dragonplus-electronics/Atom-Iss5-V002/CpuRoms8255PIA.kicad_sch

## KiCad design CpuRoms8255PIA.kicad_sch (2025-06-12)

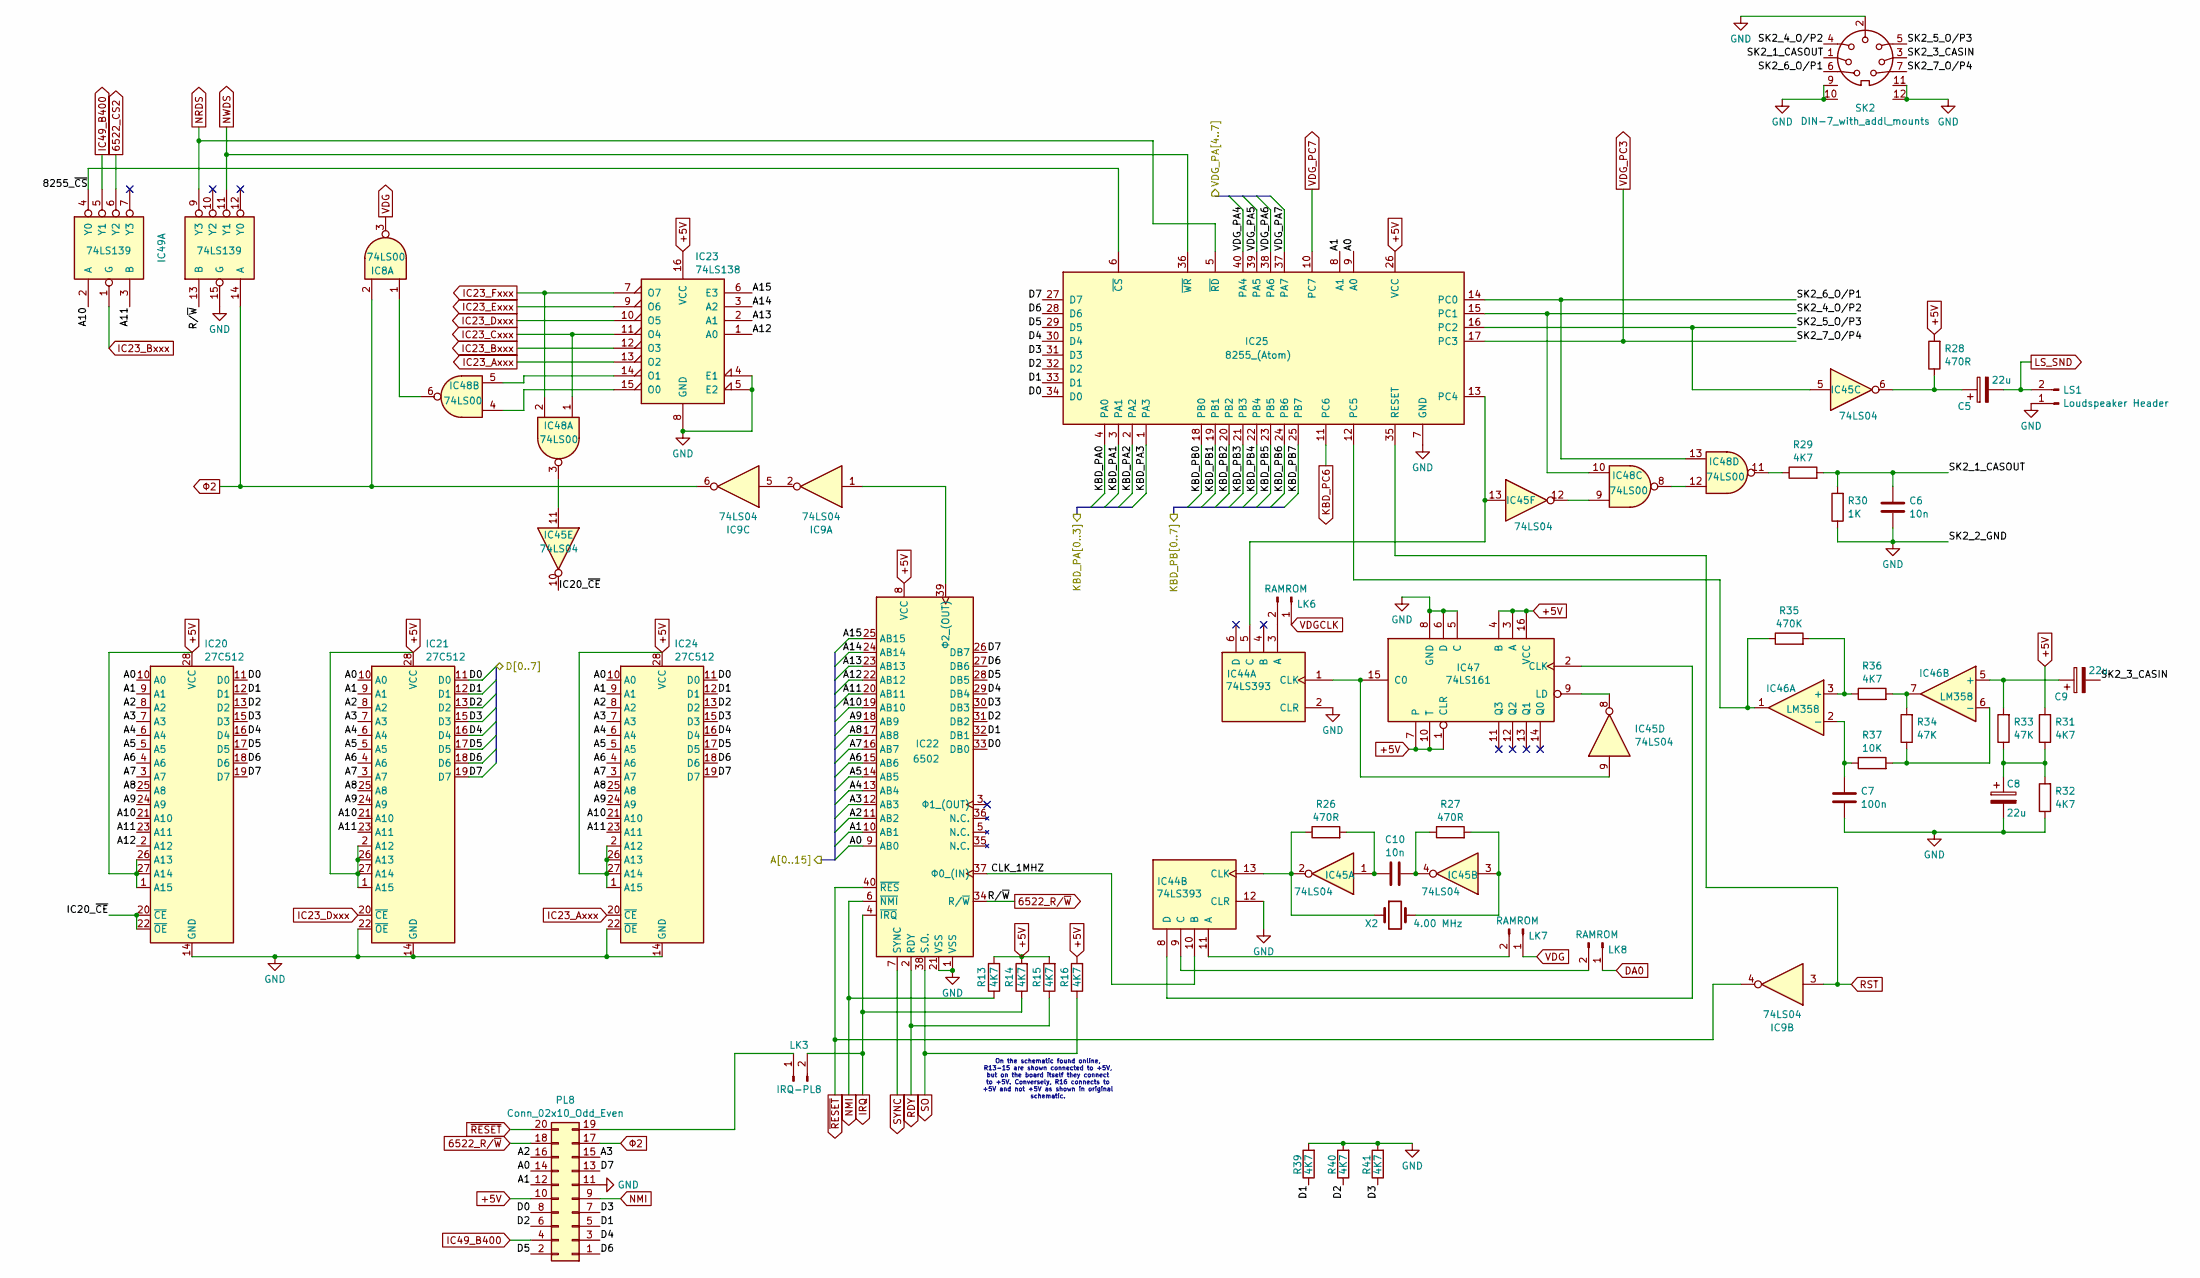
[picture p1: schematic CpuRoms8255PIA.kicad_sch]

Parts:
C5, C8, C9: 22u; CP_Radial_D5.0mm_P2.00mm
C6, C10: 10n; C_Disc_D3.0mm_W1.6mm_P2.50mm
C7: 100n; C_Disc_D3.0mm_W1.6mm_P2.50mm
IC8, IC48: 74LS00; DIP-14_W7.62mm
IC9, IC45: 74LS04; DIP-14_W7.62mm
IC20, IC21, IC24: 27C512; DIP-28_W15.24mm
IC22: 6502; DIP-40_W15.24mm
IC23: 74LS138; DIP-16_W7.62mm
IC25: 8255_(Atom); DIP-40_W15.24mm
IC44: 74LS393; DIP-14_W7.62mm
IC46: LM358; DIP-8_W7.62mm
IC47: 74LS161; DIP-16_W7.62mm
IC49: 74LS139; DIP-16_W7.62mm
LK3: IRQ-PL8; PinHeader_1x02_P2.54mm_Vertical
LK6, LK7, LK8: RAMROM; PinHeader_1x02_P2.54mm_Vertical
LS1: Loudspeaker Header; PinHeader_1x02_P2.54mm_Vertical
PL8: Conn_02x10_Odd_Even; Atom_IDC-Header_2x10_P2.54mm_Vertical
R13, R14, R15, R16, R29, R31, R32, R36, R39, R40, R41: 4K7; R_Axial_DIN0204_L3.6mm_D1.6mm_P5.08mm_Horizontal
R26, R27, R28: 470R; R_Axial_DIN0204_L3.6mm_D1.6mm_P5.08mm_Horizontal
R30: 1K; R_Axial_DIN0204_L3.6mm_D1.6mm_P5.08mm_Horizontal
R33, R34: 47K; R_Axial_DIN0204_L3.6mm_D1.6mm_P5.08mm_Horizontal
R35: 470K; R_Axial_DIN0204_L3.6mm_D1.6mm_P5.08mm_Horizontal
R37: 10K; R_Axial_DIN0204_L3.6mm_D1.6mm_P5.08mm_Horizontal
SK2: DIN-7_with_addl_mounts; DIN-7_RA
X2: 4.00 MHz; Crystal_HC49-4H_Vertical

Connections:
6522_CS2: IC49.6 (Y2)
6522_R/~W: IC22.34 (R/~W), IC49.13 (B), PL8.18
8255_~CS: IC25.6 (~CS), IC49.4 (Y0)
+5V: IC20.1 (A15), IC20.26 (A13), IC20.27 (A14), IC20.28 (VCC), IC21.1 (A15), IC21.2 (A12), IC21.26 (A13), IC21.27 (A14), IC21.28 (VCC), IC22.8 (VCC), IC23.16 (VCC), IC24.1 (A15), IC24.2 (A12), IC24.26 (A13), IC24.27 (A14), IC24.28 (VCC), IC25.26 (VCC), IC47.1 (CLR), IC47.3 (A), IC47.4 (B), IC47.7, IC47.10 (T), IC47.16 (VCC), PL8.10, R13.2, R14.2, R15.2, R16.2, R28.2, R31.2
A0: IC20.10 (A0), IC21.10 (A0), IC22.9 (AB0), IC24.10 (A0), IC25.9 (A0), PL8.14
A1: IC20.9 (A1), IC21.9 (A1), IC22.10 (AB1), IC24.9 (A1), IC25.8 (A1), PL8.12
A2: IC20.8 (A2), IC21.8 (A2), IC22.11 (AB2), IC24.8 (A2), PL8.16
A3: IC20.7 (A3), IC21.7 (A3), IC22.12 (AB3), IC24.7 (A3), PL8.15
A4: IC20.6 (A4), IC21.6 (A4), IC22.13 (AB4), IC24.6 (A4)
A5: IC20.5 (A5), IC21.5 (A5), IC22.14 (AB5), IC24.5 (A5)
A6: IC20.4 (A6), IC21.4 (A6), IC22.15 (AB6), IC24.4 (A6)
A7: IC20.3 (A7), IC21.3 (A7), IC22.16 (AB7), IC24.3 (A7)
A8: IC20.25 (A8), IC21.25 (A8), IC22.17 (AB8), IC24.25 (A8)
A9: IC20.24 (A9), IC21.24 (A9), IC22.18 (AB9), IC24.24 (A9)
A10: IC20.21 (A10), IC21.21 (A10), IC22.19 (AB10), IC24.21 (A10), IC49.2 (A)
A11: IC20.23 (A11), IC21.23 (A11), IC22.20 (AB11), IC24.23 (A11), IC49.3 (B)
A12: IC20.2 (A12), IC22.22 (AB12), IC23.1 (A0)
A13: IC22.23 (AB13), IC23.2 (A1)
A14: IC22.24 (AB14), IC23.3 (A2)
A15: IC22.25 (AB15), IC23.6 (E3)
CLK_1MHZ: IC22.37 (Φ0_(IN)), IC44.10 (B)
D0: IC20.11 (D0), IC21.11 (D0), IC22.33 (DB0), IC24.11 (D0), IC25.34 (D0), PL8.8
D1: IC20.12 (D1), IC21.12 (D1), IC22.32 (DB1), IC24.12 (D1), IC25.33 (D1), PL8.5, R39.1
D2: IC20.13 (D2), IC21.13 (D2), IC22.31 (DB2), IC24.13 (D2), IC25.32 (D2), PL8.6, R40.1
D3: IC20.15 (D3), IC21.15 (D3), IC22.30 (DB3), IC24.15 (D3), IC25.31 (D3), PL8.7, R41.1
D4: IC20.16 (D4), IC21.16 (D4), IC22.29 (DB4), IC24.16 (D4), IC25.30 (D4), PL8.3
D5: IC20.17 (D5), IC21.17 (D5), IC22.28 (DB5), IC24.17 (D5), IC25.29 (D5), PL8.2
D6: IC20.18 (D6), IC21.18 (D6), IC22.27 (DB6), IC24.18 (D6), IC25.28 (D6), PL8.1
D7: IC20.19 (D7), IC21.19 (D7), IC22.26 (DB7), IC24.19 (D7), IC25.27 (D7), PL8.13
DA0: LK8.1
GND: C6.2, C7.1, C8.2, IC20.14 (GND), IC21.14 (GND), IC21.22 (~OE), IC22.1 (VSS), IC22.21 (VSS), IC23.4 (E1), IC23.5 (E2), IC23.8 (GND), IC24.14 (GND), IC24.22 (~OE), IC25.7 (GND), IC44.2 (CLR), IC44.12 (CLR), IC47.5 (C), IC47.6 (D), IC47.8 (GND), IC49.15 (G), LS1.1, PL8.11, R30.1, R32.1, R39.2, R40.2, R41.2, SK2.2, SK2.9, SK2.10, SK2.11, SK2.12
IC20_~CE: IC20.20 (~CE), IC20.22 (~OE), IC45.10
IC23_Axxx: IC23.13 (O2), IC24.20 (~CE)
IC23_Bxxx: IC23.12 (O3), IC49.1 (G)
IC23_Cxxx: IC23.11 (O4), IC48.1
IC23_Dxxx: IC21.20 (~CE), IC23.10 (O5)
IC23_Exxx: IC23.9 (O6)
IC23_Fxxx: IC23.7 (O7), IC48.2
IC49_B400: IC49.5 (Y1), PL8.4
IRQ: IC22.4 (~IRQ), LK3.2, R14.1
KBD_PA0: IC25.4 (PA0)
KBD_PA1: IC25.3 (PA1)
KBD_PA2: IC25.2 (PA2)
KBD_PA3: IC25.1 (PA3)
KBD_PB0: IC25.18 (PB0)
KBD_PB1: IC25.19 (PB1)
KBD_PB2: IC25.20 (PB2)
KBD_PB3: IC25.21 (PB3)
KBD_PB4: IC25.22 (PB4)
KBD_PB5: IC25.23 (PB5)
KBD_PB6: IC25.24 (PB6)
KBD_PB7: IC25.25 (PB7)
KBD_PC6: IC25.11 (PC6)
LS_SND: C5.2, LS1.2
NMI: IC22.6 (~NMI), PL8.9, R13.1
NRDS: IC25.5 (~RD), IC49.9 (Y3)
NWDS: IC25.36 (~WR), IC49.11 (Y1)
unnamed: C5.1, IC45.6, R28.1
unnamed: C7.2, IC46.2 (-), R37.1
unnamed: C8.1, R31.1, R32.2, R33.1
unnamed: C9.1, IC46.5 (+), R33.2
unnamed: C10.1, IC45.1, R26.2
unnamed: C10.2, IC45.4, R27.1
unnamed: IC9.2, IC9.5
unnamed: IC9.1, IC22.39 (Φ2_(OUT))
unnamed: IC23.14 (O1), IC48.5
unnamed: IC23.15 (O0), IC48.4
unnamed: IC25.12 (PC5), IC46.1, R35.1
unnamed: IC25.13 (PC4), IC44.5 (C), IC45.13
unnamed: IC44.1 (CLK), IC45.9, IC47.15 (C0)
unnamed: IC44.3 (A), LK6.2
unnamed: IC44.8 (D), IC47.2 (CLK)
unnamed: IC44.9 (C), LK8.2
unnamed: IC44.11 (A), LK7.2
unnamed: IC44.13 (CLK), IC45.2, R26.1, X2.1
unnamed: IC45.3, R27.2, X2.2
unnamed: IC45.8, IC47.9 (LD)
unnamed: IC45.11, IC48.3
unnamed: IC45.12, IC48.9
unnamed: IC46.3 (+), R35.2, R36.1
unnamed: IC46.6 (-), R34.1, R37.2
unnamed: IC46.7, R34.2, R36.2
unnamed: IC8.1, IC48.6
unnamed: IC48.11, R29.1
unnamed: IC48.8, IC48.12
unnamed: LK3.1, PL8.19
RDY: IC22.2 (RDY), R15.1
RST: IC9.3, IC25.35 (RESET)
SK2_1_CASOUT: C6.1, R29.2, R30.2, SK2.1
SK2_3_CASIN: C9.2, SK2.3
SK2_4_O/P2: IC25.15 (PC1), IC48.10, SK2.4
SK2_5_O/P3: IC25.16 (PC2), IC45.5, SK2.5
SK2_6_O/P1: IC25.14 (PC0), IC48.13, SK2.6
SO: IC22.38 (S.O.), R16.1
SYNC: IC22.7 (SYNC)
VDG: IC8.3, LK7.1
VDGCLK: LK6.1
VDG_PA4: IC25.40 (PA4)
VDG_PA5: IC25.39 (PA5)
VDG_PA6: IC25.38 (PA6)
VDG_PA7: IC25.37 (PA7)
VDG_PC3: IC25.17 (PC3), SK2.7
VDG_PC7: IC25.10 (PC7)
~RESET: IC9.4, IC22.40 (~RES), PL8.20
Φ2: IC8.2, IC9.6, IC49.14 (A), PL8.17

Notes on the sheet:
On the schematic found online, R13-15 are shown connected to +5V, but on the board itself they connect to +5V. Conversely, R16 connects to +5V and not +5V as shown in original schematic.
