dragonplus-electronics/Atom-Iss5-V002/MainMem.kicad_sch

## KiCad design MainMem.kicad_sch (2025-06-12)

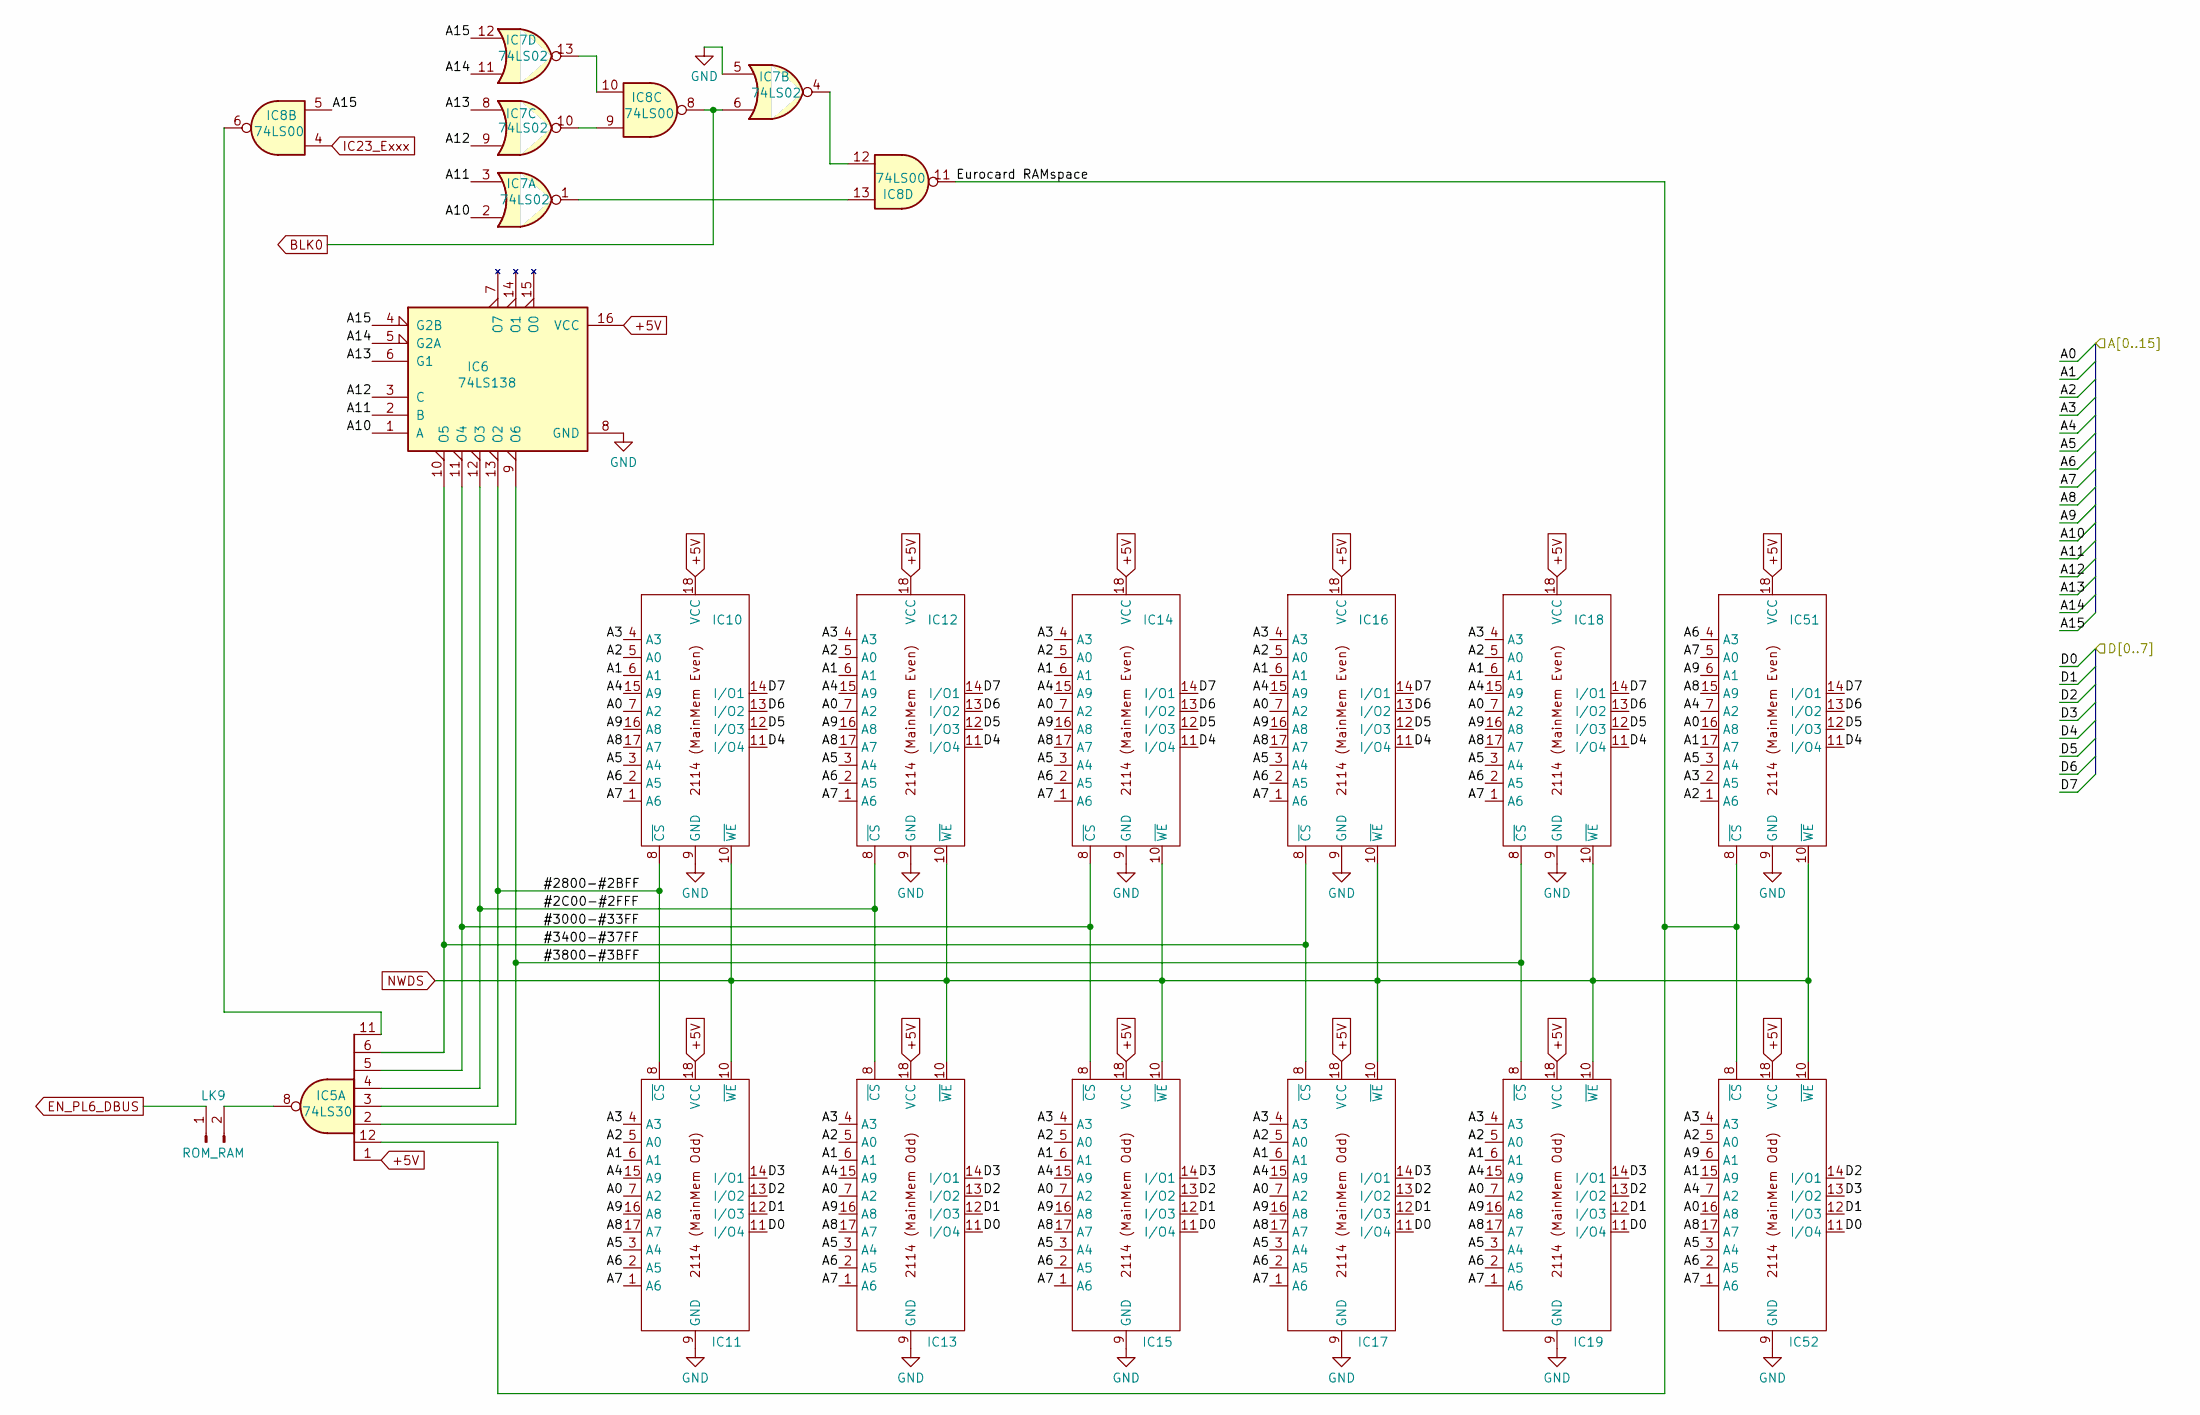
[picture p2: schematic MainMem.kicad_sch]

Parts:
IC5: 74LS30; DIP-14_W7.62mm
IC6: 74LS138; DIP-16_W7.62mm
IC7: 74LS02; DIP-14_W7.62mm
IC8: 74LS00; DIP-14_W7.62mm
IC10, IC11, IC12, IC13, IC14, IC15, IC16, IC17, IC18, IC19, IC51, IC52: 2114; DIP-18_W7.62mm
LK9: ROM_RAM; PinHeader_1x02_P2.54mm_Vertical

Connections:
#2C00-#2FFF: IC5.4, IC6.12 (O3), IC12.8 (~CS), IC13.8 (~CS)
#2800-#2BFF: IC5.3, IC6.13 (O2), IC10.8 (~CS), IC11.8 (~CS)
#3000-#33FF: IC5.5, IC6.11 (O4), IC14.8 (~CS), IC15.8 (~CS)
#3400-#37FF: IC5.6, IC6.10 (O5), IC16.8 (~CS), IC17.8 (~CS)
#3800-#3BFF: IC5.2, IC6.9 (O6), IC18.8 (~CS), IC19.8 (~CS)
+5V: IC5.1, IC6.16 (VCC), IC10.18 (VCC), IC11.18 (VCC), IC12.18 (VCC), IC13.18 (VCC), IC14.18 (VCC), IC15.18 (VCC), IC16.18 (VCC), IC17.18 (VCC), IC18.18 (VCC), IC19.18 (VCC), IC51.18 (VCC), IC52.18 (VCC)
A0: IC10.7 (A2), IC11.7 (A2), IC12.7 (A2), IC13.7 (A2), IC14.7 (A2), IC15.7 (A2), IC16.7 (A2), IC17.7 (A2), IC18.7 (A2), IC19.7 (A2), IC51.16 (A8), IC52.16 (A8)
A1: IC10.6 (A1), IC11.6 (A1), IC12.6 (A1), IC13.6 (A1), IC14.6 (A1), IC15.6 (A1), IC16.6 (A1), IC17.6 (A1), IC18.6 (A1), IC19.6 (A1), IC51.17 (A7), IC52.15 (A9)
A2: IC10.5 (A0), IC11.5 (A0), IC12.5 (A0), IC13.5 (A0), IC14.5 (A0), IC15.5 (A0), IC16.5 (A0), IC17.5 (A0), IC18.5 (A0), IC19.5 (A0), IC51.1 (A6), IC52.5 (A0)
A3: IC10.4 (A3), IC11.4 (A3), IC12.4 (A3), IC13.4 (A3), IC14.4 (A3), IC15.4 (A3), IC16.4 (A3), IC17.4 (A3), IC18.4 (A3), IC19.4 (A3), IC51.2 (A5), IC52.4 (A3)
A4: IC10.15 (A9), IC11.15 (A9), IC12.15 (A9), IC13.15 (A9), IC14.15 (A9), IC15.15 (A9), IC16.15 (A9), IC17.15 (A9), IC18.15 (A9), IC19.15 (A9), IC51.7 (A2), IC52.7 (A2)
A5: IC10.3 (A4), IC11.3 (A4), IC12.3 (A4), IC13.3 (A4), IC14.3 (A4), IC15.3 (A4), IC16.3 (A4), IC17.3 (A4), IC18.3 (A4), IC19.3 (A4), IC51.3 (A4), IC52.3 (A4)
A6: IC10.2 (A5), IC11.2 (A5), IC12.2 (A5), IC13.2 (A5), IC14.2 (A5), IC15.2 (A5), IC16.2 (A5), IC17.2 (A5), IC18.2 (A5), IC19.2 (A5), IC51.4 (A3), IC52.2 (A5)
A7: IC10.1 (A6), IC11.1 (A6), IC12.1 (A6), IC13.1 (A6), IC14.1 (A6), IC15.1 (A6), IC16.1 (A6), IC17.1 (A6), IC18.1 (A6), IC19.1 (A6), IC51.5 (A0), IC52.1 (A6)
A8: IC10.17 (A7), IC11.17 (A7), IC12.17 (A7), IC13.17 (A7), IC14.17 (A7), IC15.17 (A7), IC16.17 (A7), IC17.17 (A7), IC18.17 (A7), IC19.17 (A7), IC51.15 (A9), IC52.17 (A7)
A9: IC10.16 (A8), IC11.16 (A8), IC12.16 (A8), IC13.16 (A8), IC14.16 (A8), IC15.16 (A8), IC16.16 (A8), IC17.16 (A8), IC18.16 (A8), IC19.16 (A8), IC51.6 (A1), IC52.6 (A1)
A10: IC6.1 (A), IC7.2
A11: IC6.2 (B), IC7.3
A12: IC6.3 (C), IC7.9
A13: IC6.6 (G1), IC7.8
A14: IC6.5 (G2A), IC7.11
A15: IC6.4 (G2B), IC7.12, IC8.5
BLK0: IC7.6, IC8.8
D0: IC11.11 (I/O4), IC13.11 (I/O4), IC15.11 (I/O4), IC17.11 (I/O4), IC19.11 (I/O4), IC52.11 (I/O4)
D1: IC11.12 (I/O3), IC13.12 (I/O3), IC15.12 (I/O3), IC17.12 (I/O3), IC19.12 (I/O3), IC52.12 (I/O3)
D2: IC11.13 (I/O2), IC13.13 (I/O2), IC15.13 (I/O2), IC17.13 (I/O2), IC19.13 (I/O2), IC52.14 (I/O1)
D3: IC11.14 (I/O1), IC13.14 (I/O1), IC15.14 (I/O1), IC17.14 (I/O1), IC19.14 (I/O1), IC52.13 (I/O2)
D4: IC10.11 (I/O4), IC12.11 (I/O4), IC14.11 (I/O4), IC16.11 (I/O4), IC18.11 (I/O4), IC51.11 (I/O4)
D5: IC10.12 (I/O3), IC12.12 (I/O3), IC14.12 (I/O3), IC16.12 (I/O3), IC18.12 (I/O3), IC51.12 (I/O3)
D6: IC10.13 (I/O2), IC12.13 (I/O2), IC14.13 (I/O2), IC16.13 (I/O2), IC18.13 (I/O2), IC51.13 (I/O2)
D7: IC10.14 (I/O1), IC12.14 (I/O1), IC14.14 (I/O1), IC16.14 (I/O1), IC18.14 (I/O1), IC51.14 (I/O1)
EN_PL6_DBUS: LK9.1
Eurocard RAMspace: IC5.12, IC8.11, IC51.8 (~CS), IC52.8 (~CS)
GND: IC6.8 (GND), IC7.5, IC10.9 (GND), IC11.9 (GND), IC12.9 (GND), IC13.9 (GND), IC14.9 (GND), IC15.9 (GND), IC16.9 (GND), IC17.9 (GND), IC18.9 (GND), IC19.9 (GND), IC51.9 (GND), IC52.9 (GND)
IC23_Exxx: IC8.4
NWDS: IC10.10 (~WE), IC11.10 (~WE), IC12.10 (~WE), IC13.10 (~WE), IC14.10 (~WE), IC15.10 (~WE), IC16.10 (~WE), IC17.10 (~WE), IC18.10 (~WE), IC19.10 (~WE), IC51.10 (~WE), IC52.10 (~WE)
unnamed: IC5.8, LK9.2
unnamed: IC5.11, IC8.6
unnamed: IC7.1, IC8.13
unnamed: IC7.4, IC8.12
unnamed: IC7.10, IC8.9
unnamed: IC7.13, IC8.10
