dragonplus-electronics/Atom-Iss5-V002/PiaPorts.kicad_sch

## KiCad design PiaPorts.kicad_sch (2025-06-12)

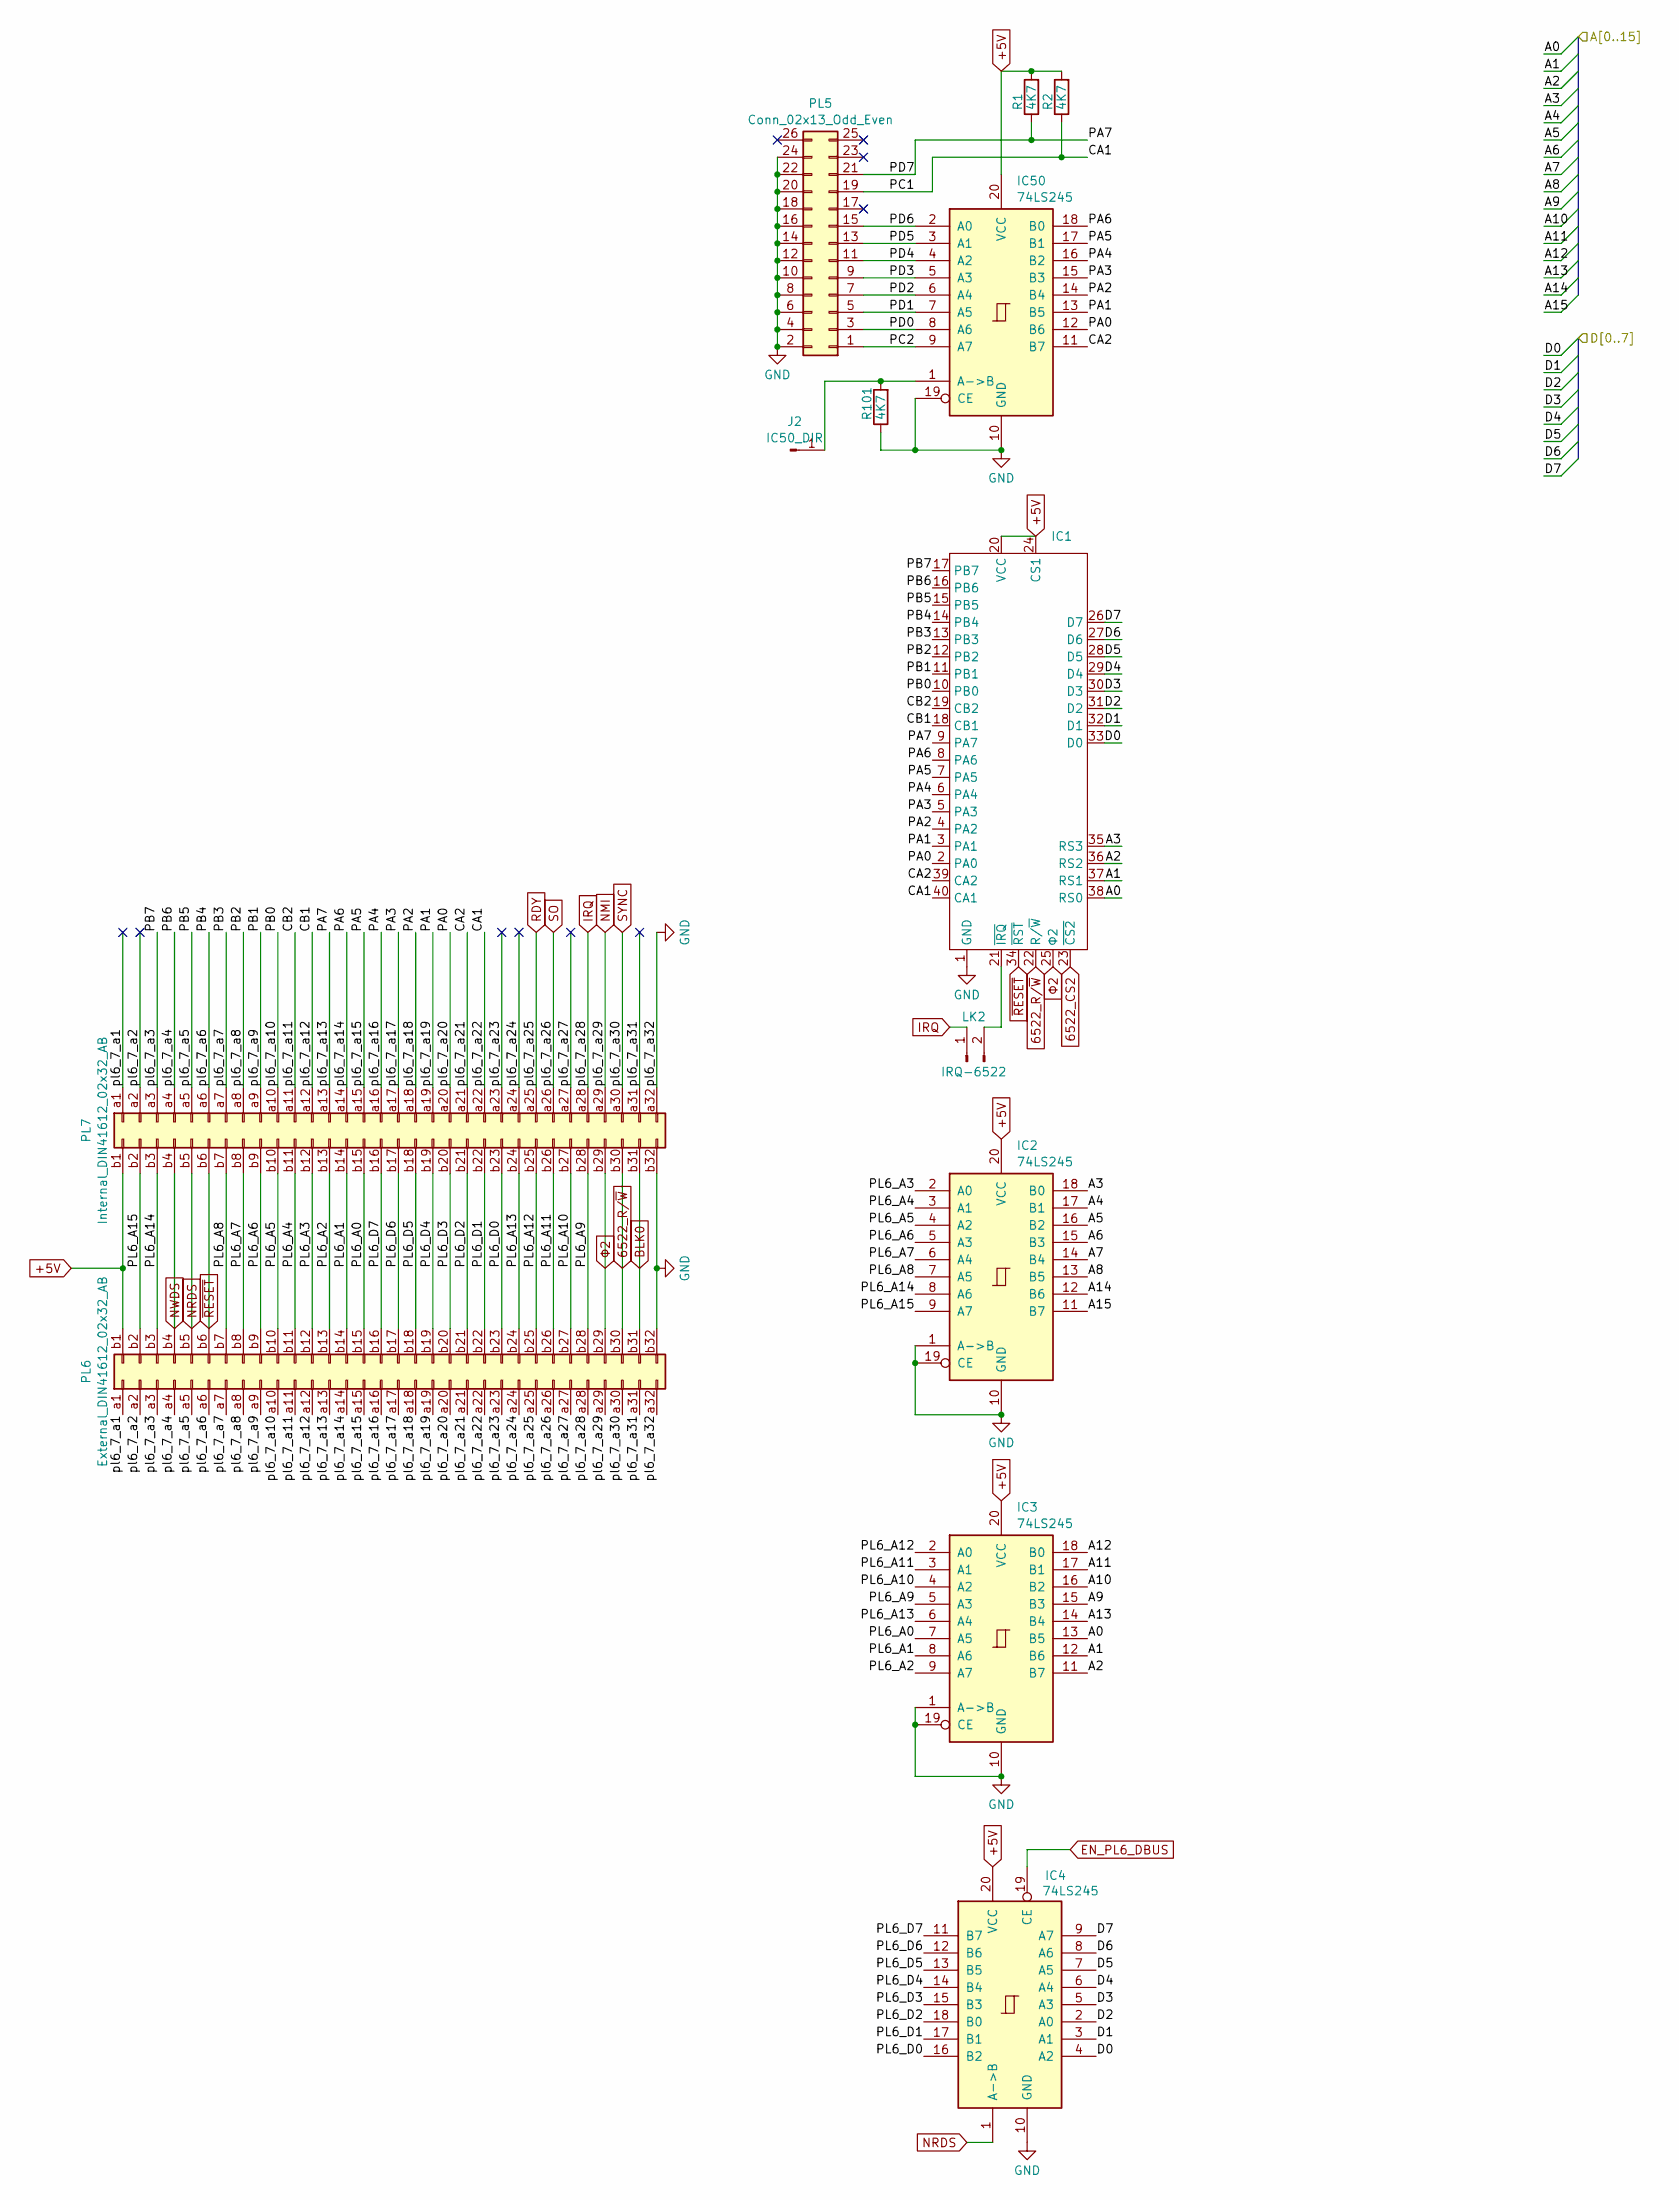
[picture p3: schematic PiaPorts.kicad_sch]

Parts:
IC1: DIP-40_W15.24mm
IC2, IC3, IC4, IC50: 74LS245; DIP-20_W7.62mm
J2: IC50_DIR; PinHeader_1x01_P1.00mm_Vertical
LK2: IRQ-6522; PinHeader_1x02_P2.54mm_Vertical
PL5: Conn_02x13_Odd_Even; IDC-Header_2x13_P2.54mm_Horizontal
PL6: External_DIN41612_02x32_AB; DIN41612_B_2x32_Male_Horizontal_THT_NoMountHoles
PL7: Internal_DIN41612_02x32_AB; DIN41612_B_2x32_Female_Vertical_THT
R1, R2, R101: 4K7; R_Axial_DIN0204_L3.6mm_D1.6mm_P5.08mm_Horizontal

Connections:
6522_CS2: IC1.23 (~CS2)
6522_R/~W: IC1.22 (R/~W), PL6.b30, PL7.b30
+5V: IC1.20 (VCC), IC1.24 (CS1), IC2.20 (VCC), IC3.20 (VCC), IC4.20 (VCC), IC50.20 (VCC), PL6.b1, PL7.b1, R1.2, R2.2
A0: IC1.38 (RS0), IC3.13 (B5)
A1: IC1.37 (RS1), IC3.12 (B6)
A2: IC1.36 (RS2), IC3.11 (B7)
A3: IC1.35 (RS3), IC2.18 (B0)
A4: IC2.17 (B1)
A5: IC2.16 (B2)
A6: IC2.15 (B3)
A7: IC2.14 (B4)
A8: IC2.13 (B5)
A9: IC3.15 (B3)
A10: IC3.16 (B2)
A11: IC3.17 (B1)
A12: IC3.18 (B0)
A13: IC3.14 (B4)
A14: IC2.12 (B6)
A15: IC2.11 (B7)
BLK0: PL6.b31, PL7.b31
CA1: IC1.40 (CA1), PL5.19, PL6.a22, PL7.a22, R2.1
CA2: IC1.39 (CA2), IC50.11 (B7), PL6.a21, PL7.a21
CB1: IC1.18 (CB1), PL6.a12, PL7.a12
CB2: IC1.19 (CB2), PL6.a11, PL7.a11
D0: IC1.33 (D0), IC4.4 (A2)
D1: IC1.32 (D1), IC4.3 (A1)
D2: IC1.31 (D2), IC4.2 (A0)
D3: IC1.30 (D3), IC4.5 (A3)
D4: IC1.29 (D4), IC4.6 (A4)
D5: IC1.28 (D5), IC4.7 (A5)
D6: IC1.27 (D6), IC4.8 (A6)
D7: IC1.26 (D7), IC4.9 (A7)
EN_PL6_DBUS: IC4.19 (CE)
GND: IC1.1 (GND), IC2.1 (A->B), IC2.10 (GND), IC2.19 (CE), IC3.1 (A->B), IC3.10 (GND), IC3.19 (CE), IC4.10 (GND), IC50.10 (GND), IC50.19 (CE), PL5.2, PL5.4, PL5.6, PL5.8, PL5.10, PL5.12, PL5.14, PL5.16, PL5.18, PL5.20, PL5.22, PL5.24, PL6.a32, PL6.b32, PL7.a32, PL7.b32, R101.1
IRQ: LK2.1, PL6.a28, PL7.a28
NMI: PL6.a29, PL7.a29
NRDS: IC4.1 (A->B), PL6.b5, PL7.b5
NWDS: PL6.b4, PL7.b4
unnamed: IC1.21 (~IRQ), LK2.2
unnamed: IC50.1 (A->B), J2.1, R101.2
PA0: IC1.2 (PA0), IC50.12 (B6), PL6.a20, PL7.a20
PA1: IC1.3 (PA1), IC50.13 (B5), PL6.a19, PL7.a19
PA2: IC1.4 (PA2), IC50.14 (B4), PL6.a18, PL7.a18
PA3: IC1.5 (PA3), IC50.15 (B3), PL6.a17, PL7.a17
PA4: IC1.6 (PA4), IC50.16 (B2), PL6.a16, PL7.a16
PA5: IC1.7 (PA5), IC50.17 (B1), PL6.a15, PL7.a15
PA6: IC1.8 (PA6), IC50.18 (B0), PL6.a14, PL7.a14
PA7: IC1.9 (PA7), PL5.21, PL6.a13, PL7.a13, R1.1
PB0: IC1.10 (PB0), PL6.a10, PL7.a10
PB1: IC1.11 (PB1), PL6.a9, PL7.a9
PB2: IC1.12 (PB2), PL6.a8, PL7.a8
PB3: IC1.13 (PB3), PL6.a7, PL7.a7
PB4: IC1.14 (PB4), PL6.a6, PL7.a6
PB5: IC1.15 (PB5), PL6.a5, PL7.a5
PB6: IC1.16 (PB6), PL6.a4, PL7.a4
PB7: IC1.17 (PB7), PL6.a3, PL7.a3
PC2: IC50.9 (A7), PL5.1
PD0: IC50.8 (A6), PL5.3
PD1: IC50.7 (A5), PL5.5
PD2: IC50.6 (A4), PL5.7
PD3: IC50.5 (A3), PL5.9
PD4: IC50.4 (A2), PL5.11
PD5: IC50.3 (A1), PL5.13
PD6: IC50.2 (A0), PL5.15
PL6_A0: IC3.7 (A5), PL6.b15, PL7.b15
PL6_A1: IC3.8 (A6), PL6.b14, PL7.b14
PL6_A2: IC3.9 (A7), PL6.b13, PL7.b13
PL6_A3: IC2.2 (A0), PL6.b12, PL7.b12
PL6_A4: IC2.3 (A1), PL6.b11, PL7.b11
PL6_A5: IC2.4 (A2), PL6.b10, PL7.b10
PL6_A6: IC2.5 (A3), PL6.b9, PL7.b9
PL6_A7: IC2.6 (A4), PL6.b8, PL7.b8
PL6_A8: IC2.7 (A5), PL6.b7, PL7.b7
PL6_A9: IC3.5 (A3), PL6.b28, PL7.b28
PL6_A10: IC3.4 (A2), PL6.b27, PL7.b27
PL6_A11: IC3.3 (A1), PL6.b26, PL7.b26
PL6_A12: IC3.2 (A0), PL6.b25, PL7.b25
PL6_A13: IC3.6 (A4), PL6.b24, PL7.b24
PL6_A14: IC2.8 (A6), PL6.b3, PL7.b3
PL6_A15: IC2.9 (A7), PL6.b2, PL7.b2
PL6_D0: IC4.16 (B2), PL6.b23, PL7.b23
PL6_D1: IC4.17 (B1), PL6.b22, PL7.b22
PL6_D2: IC4.18 (B0), PL6.b21, PL7.b21
PL6_D3: IC4.15 (B3), PL6.b20, PL7.b20
PL6_D4: IC4.14 (B4), PL6.b19, PL7.b19
PL6_D5: IC4.13 (B5), PL6.b18, PL7.b18
PL6_D6: IC4.12 (B6), PL6.b17, PL7.b17
PL6_D7: IC4.11 (B7), PL6.b16, PL7.b16
RDY: PL6.a25, PL7.a25
SO: PL6.a26, PL7.a26
SYNC: PL6.a30, PL7.a30
pl6_7_a1: PL6.a1, PL7.a1
pl6_7_a2: PL6.a2, PL7.a2
pl6_7_a23: PL6.a23, PL7.a23
pl6_7_a24: PL6.a24, PL7.a24
pl6_7_a27: PL6.a27, PL7.a27
pl6_7_a31: PL6.a31, PL7.a31
~RESET: IC1.34 (~RST), PL6.b6, PL7.b6
Φ2: IC1.25 (Φ2), PL6.b29, PL7.b29
