dragonplus-electronics/Atom-Iss5-V002/Power.kicad_sch

## KiCad design Power.kicad_sch (2025-06-12)

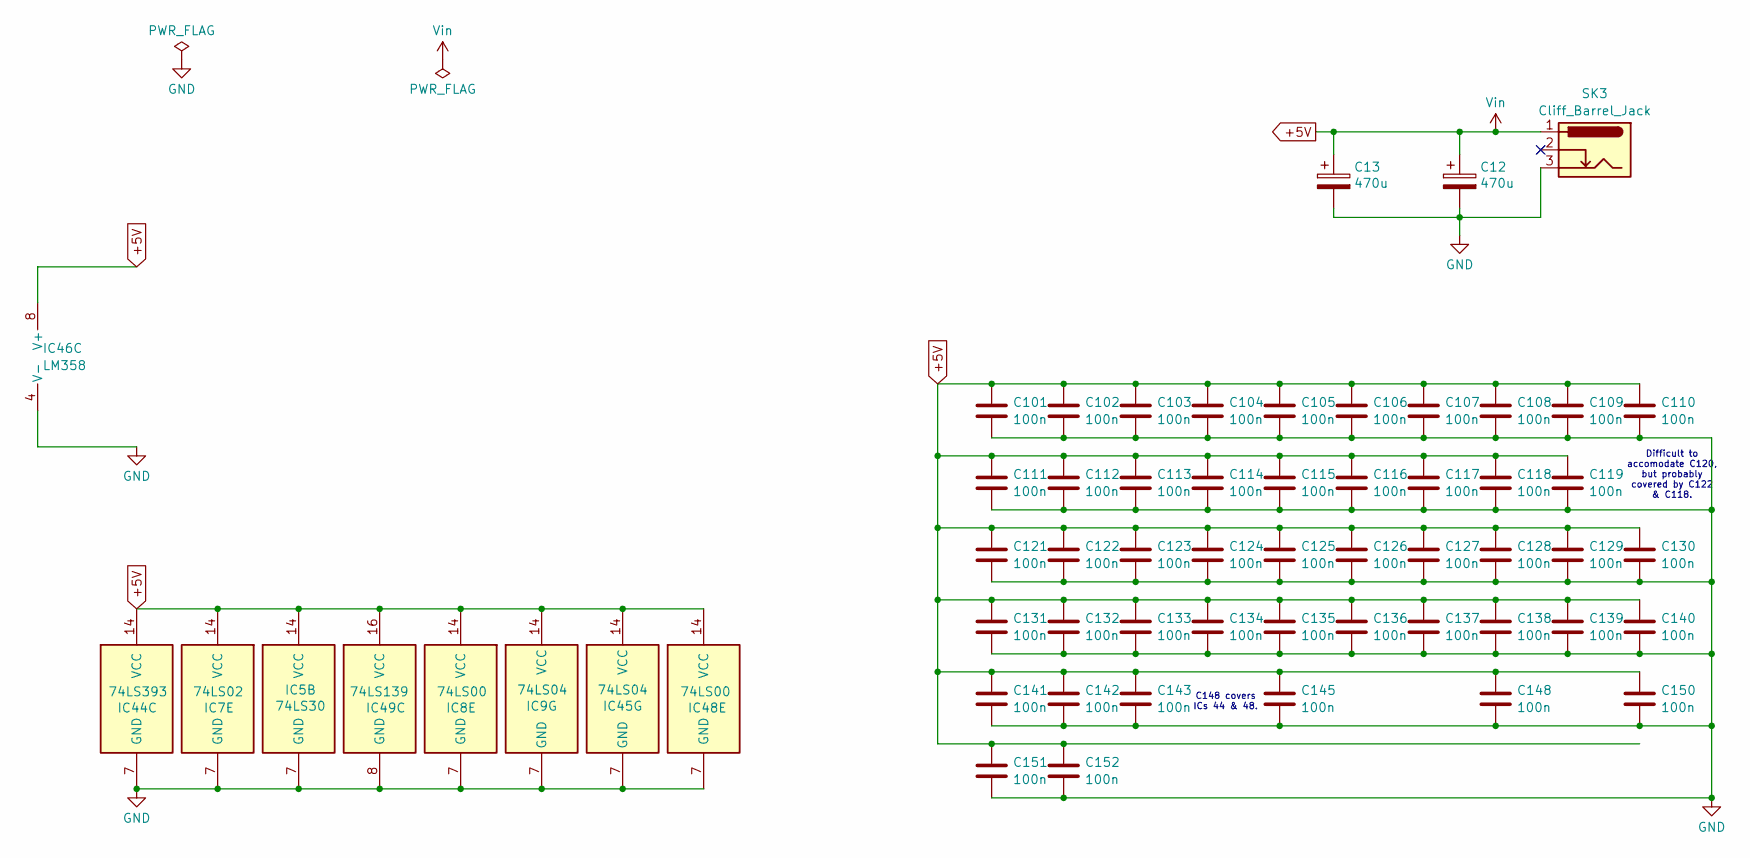
[picture p4: schematic Power.kicad_sch]

Parts:
C12, C13: 470u; CP_Radial_D10.0mm_P5.00mm
C101, C102, C103, C104, C105, C106, C107, C108, C109, C110, C111, C112, C113, C114, C115, C116, C117, C118, C119, C121, C122, C123, C124, C125, C126, C127, C128, C129, C130, C131, C132, C133, C134, C135, C136, C137, C138, C139, C140, C141, C142, C143, C145, C148, C150, C151, C152: 100n; C_Disc_D3.0mm_W1.6mm_P2.50mm
IC5: 74LS30; DIP-14_W7.62mm
IC7: 74LS02; DIP-14_W7.62mm
IC8, IC48: 74LS00; DIP-14_W7.62mm
IC9, IC45: 74LS04; DIP-14_W7.62mm
IC44: 74LS393; DIP-14_W7.62mm
IC46: LM358; DIP-8_W7.62mm
IC49: 74LS139; DIP-16_W7.62mm
SK3: Cliff_Barrel_Jack; Cliff_FC681461_Barrel_Jack

Connections:
+5V: C12.1, C13.1, C101.1, C102.1, C103.1, C104.1, C105.1, C106.1, C107.1, C108.1, C109.1, C110.1, C111.1, C112.1, C113.1, C114.1, C115.1, C116.1, C117.1, C118.1, C119.1, C121.1, C122.1, C123.1, C124.1, C125.1, C126.1, C127.1, C128.1, C129.1, C130.1, C131.1, C132.1, C133.1, C134.1, C135.1, C136.1, C137.1, C138.1, C139.1, C140.1, C141.1, C142.1, C143.1, C145.1, C148.1, C150.1, C151.1, C152.1, IC5.14 (VCC), IC7.14 (VCC), IC8.14 (VCC), IC9.14 (VCC), IC44.14 (VCC), IC45.14 (VCC), IC46.8 (V+), IC48.14 (VCC), IC49.16 (VCC), SK3.1
GND: C12.2, C13.2, C101.2, C102.2, C103.2, C104.2, C105.2, C106.2, C107.2, C108.2, C109.2, C110.2, C111.2, C112.2, C113.2, C114.2, C115.2, C116.2, C117.2, C118.2, C119.2, C121.2, C122.2, C123.2, C124.2, C125.2, C126.2, C127.2, C128.2, C129.2, C130.2, C131.2, C132.2, C133.2, C134.2, C135.2, C136.2, C137.2, C138.2, C139.2, C140.2, C141.2, C142.2, C143.2, C145.2, C148.2, C150.2, C151.2, C152.2, IC5.7 (GND), IC7.7 (GND), IC8.7 (GND), IC9.7 (GND), IC44.7 (GND), IC45.7 (GND), IC46.4 (V-), IC48.7 (GND), IC49.8 (GND), SK3.3

Notes on the sheet:
Difficult to accomodate C120, but probably covered by C122 & C118.
C148 covers ICs 44 & 48.
