dragonplus-electronics/Atom-Iss5-V002/keybd.kicad_sch

## KiCad design keybd.kicad_sch (2025-06-12)

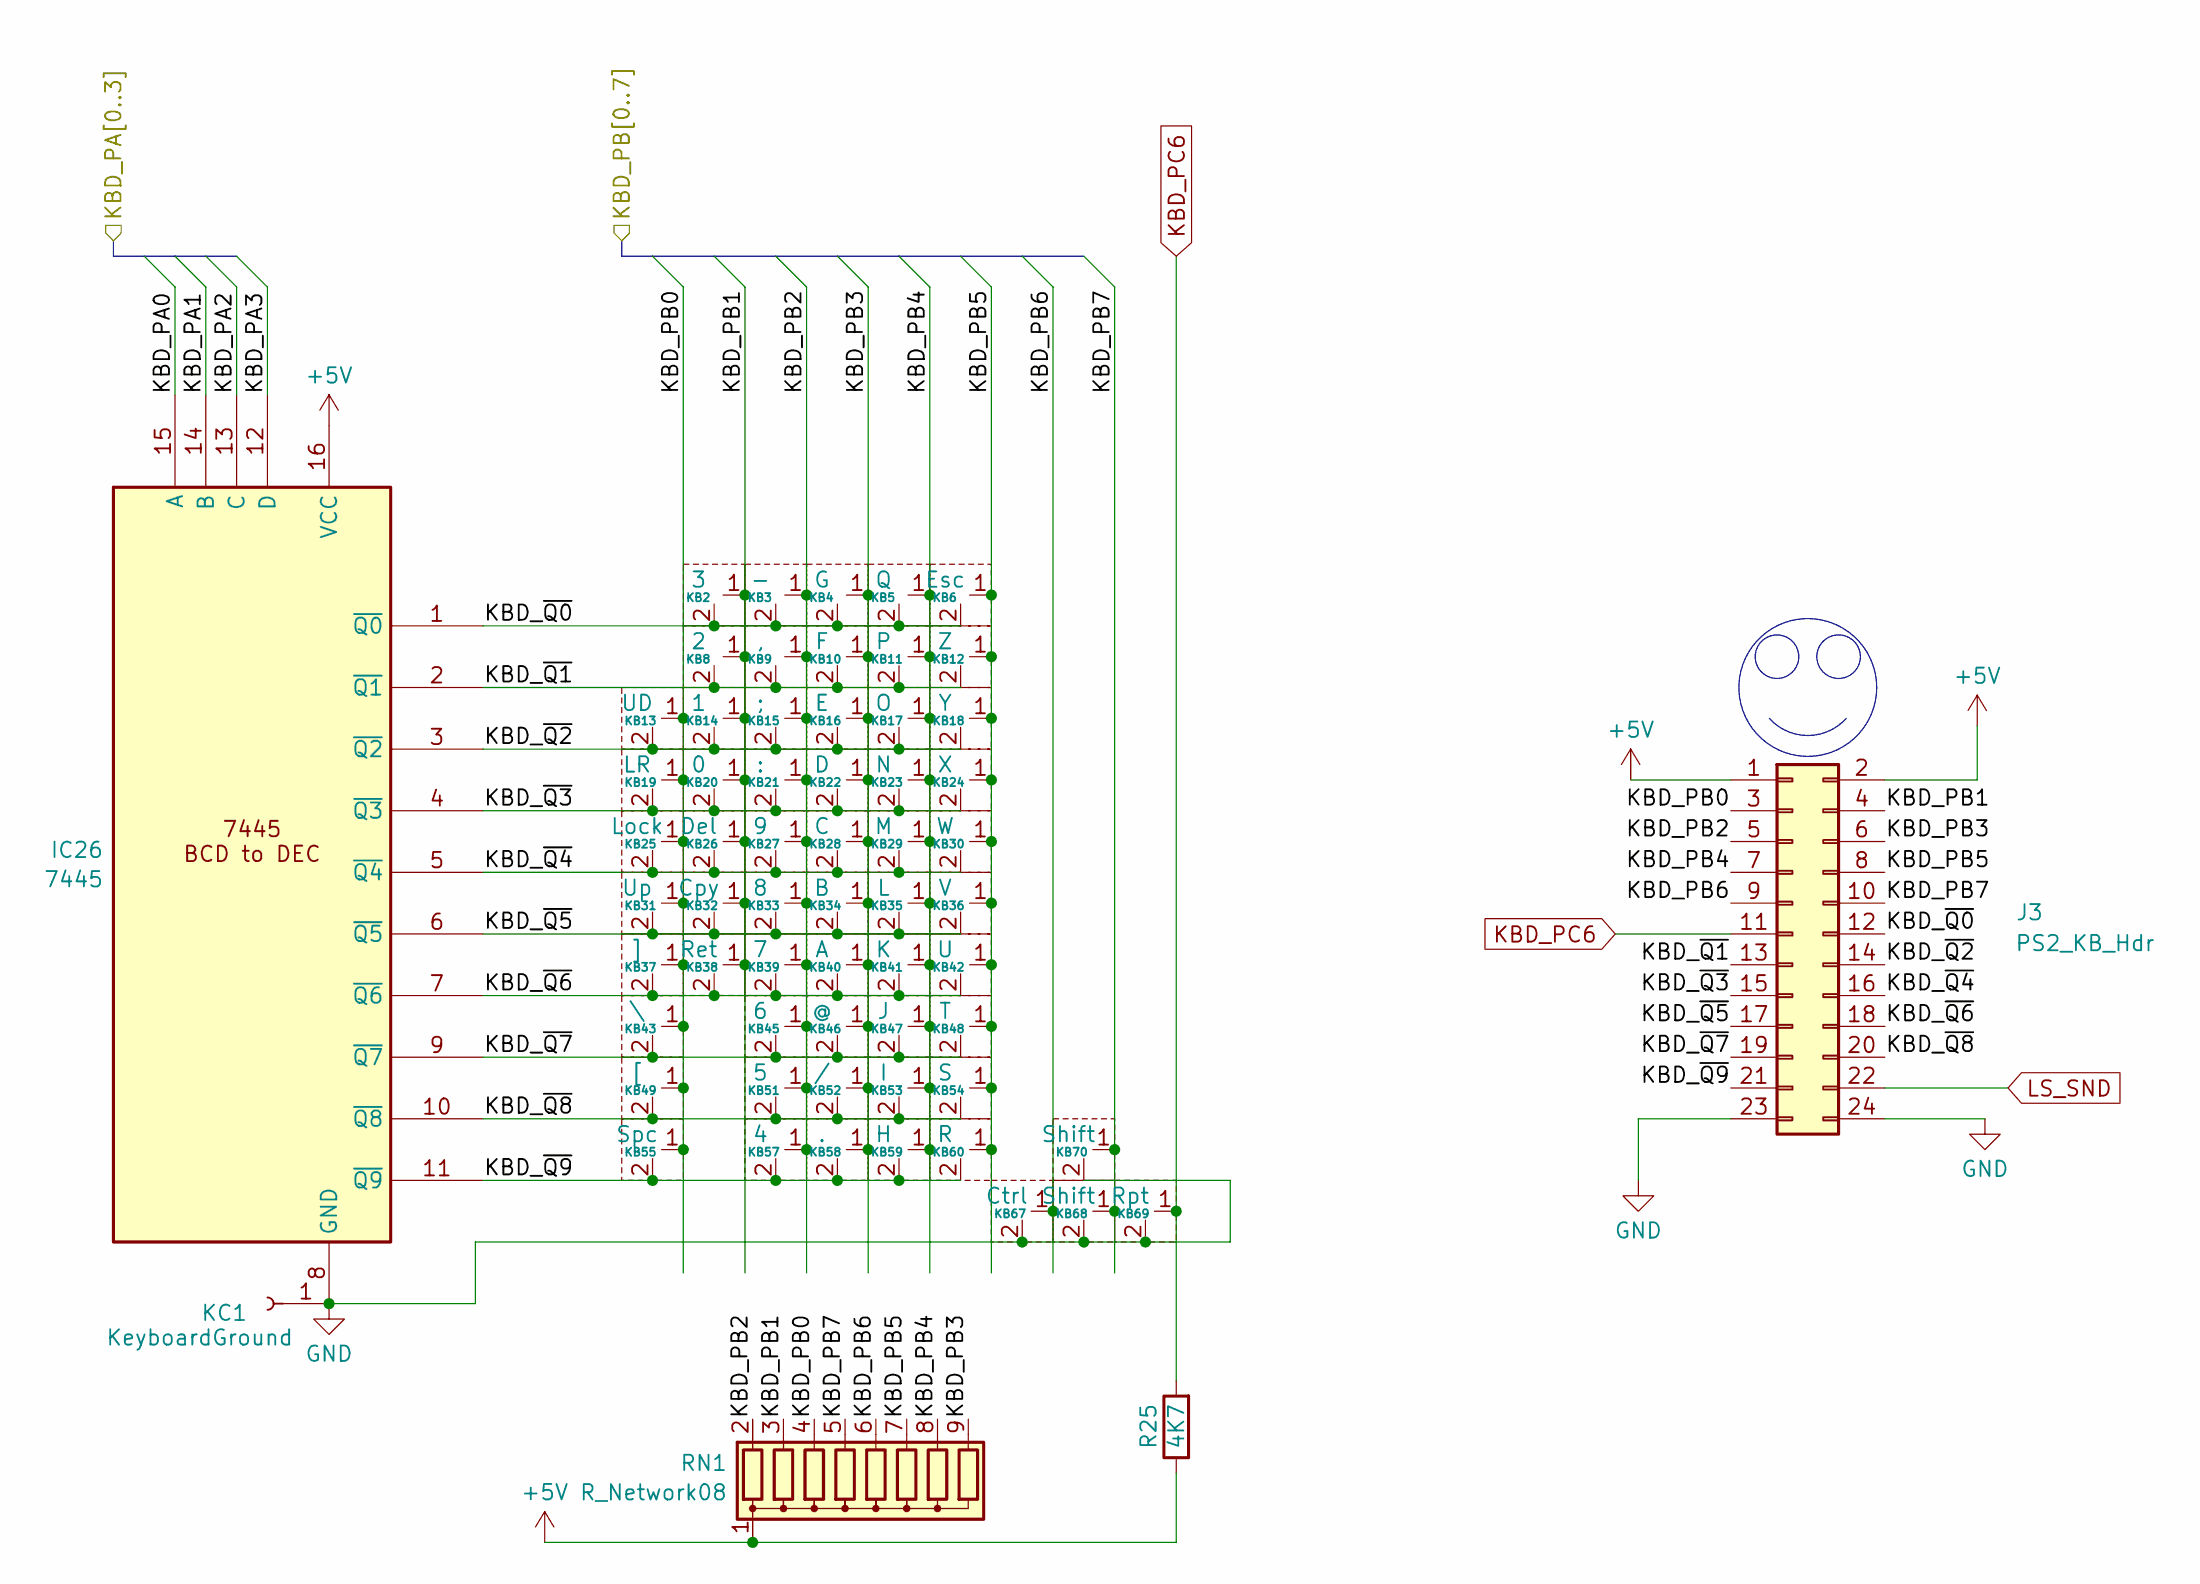
[picture p5: schematic keybd.kicad_sch]

Parts:
IC26: 7445; DIP-16_W7.62mm
J3: PS2_KB_Hdr; IDC-Header_2x12_P2.54mm_Vertical
KB2: 3; AtomKeyswitch
KB3: -; AtomKeyswitch
KB4: G; AtomKeyswitch
KB5: Q; AtomKeyswitch
KB6: Esc; AtomKeyswitch
KB8: 2; AtomKeyswitch
KB9: ,; AtomKeyswitch
KB10: F; AtomKeyswitch
KB11: P; AtomKeyswitch
KB12: Z; AtomKeyswitch
KB13: UD; AtomKeyswitch
KB14: 1; AtomKeyswitch
KB15: ;; AtomKeyswitch
KB16: E; AtomKeyswitch
KB17: O; AtomKeyswitch
KB18: Y; AtomKeyswitch
KB19: LR; AtomKeyswitch
KB20: 0; AtomKeyswitch
KB21: :; AtomKeyswitch
KB22: D; AtomKeyswitch
KB23: N; AtomKeyswitch
KB24: X; AtomKeyswitch
KB25: Lock; AtomKeyswitch
KB26: Del; AtomKeyswitch
KB27: 9; AtomKeyswitch
KB28: C; AtomKeyswitch
KB29: M; AtomKeyswitch
KB30: W; AtomKeyswitch
KB31: Up; AtomKeyswitch
KB32: Cpy; AtomKeyswitch
KB33: 8; AtomKeyswitch
KB34: B; AtomKeyswitch
KB35: L; AtomKeyswitch
KB36: V; AtomKeyswitch
KB37: ]; AtomKeyswitch
KB38: Ret; AtomKeyswitch
KB39: 7; AtomKeyswitch
KB40: A; AtomKeyswitch
KB41: K; AtomKeyswitch
KB42: U; AtomKeyswitch
KB43: \; AtomKeyswitch
KB45: 6; AtomKeyswitch
KB46: @; AtomKeyswitch
KB47: J; AtomKeyswitch
KB48: T; AtomKeyswitch
KB49: [; AtomKeyswitch
KB51: 5; AtomKeyswitch
KB52: /; AtomKeyswitch
KB53: I; AtomKeyswitch
KB54: S; AtomKeyswitch
KB55: Spc; AtomKeyswitch
KB57: 4; AtomKeyswitch
KB58: .; AtomKeyswitch
KB59: H; AtomKeyswitch
KB60: R; AtomKeyswitch
KB67: Ctrl; AtomKeyswitch
KB68, KB70: Shift; AtomKeyswitch
KB69: Rpt; AtomKeyswitch
KC1: KeyboardGround
R25: 4K7; R_Axial_DIN0204_L3.6mm_D1.6mm_P5.08mm_Horizontal
RN1: R_Network08; R_Array_SIP9

Connections:
+5V: IC26.16 (VCC), J3.1, J3.2, R25.1, RN1.1 (common)
GND: IC26.8 (GND), J3.23, J3.24, KB67.2, KB68.2, KB69.2, KB70.2, KC1.1
KBD_PA0: IC26.15 (A)
KBD_PA1: IC26.14 (B)
KBD_PA2: IC26.13 (C)
KBD_PA3: IC26.12 (D)
KBD_PB0: J3.3, KB13.1, KB19.1, KB25.1, KB31.1, KB37.1, KB43.1, KB49.1, KB55.1, RN1.4 (R3)
KBD_PB1: J3.4, KB2.1, KB8.1, KB14.1, KB20.1, KB26.1, KB32.1, KB38.1, RN1.3 (R2)
KBD_PB2: J3.5, KB3.1, KB9.1, KB15.1, KB21.1, KB27.1, KB33.1, KB39.1, KB45.1, KB51.1, KB57.1, RN1.2 (R1)
KBD_PB3: J3.6, KB4.1, KB10.1, KB16.1, KB22.1, KB28.1, KB34.1, KB40.1, KB46.1, KB52.1, KB58.1, RN1.9 (R8)
KBD_PB4: J3.7, KB5.1, KB11.1, KB17.1, KB23.1, KB29.1, KB35.1, KB41.1, KB47.1, KB53.1, KB59.1, RN1.8 (R7)
KBD_PB5: J3.8, KB6.1, KB12.1, KB18.1, KB24.1, KB30.1, KB36.1, KB42.1, KB48.1, KB54.1, KB60.1, RN1.7 (R6)
KBD_PB6: J3.9, KB67.1, RN1.6 (R5)
KBD_PB7: J3.10, KB68.1, KB70.1, RN1.5 (R4)
KBD_PC6: J3.11, KB69.1, R25.2
KBD_~Q0: IC26.1 (~Q0), J3.12, KB2.2, KB3.2, KB4.2, KB5.2, KB6.2
KBD_~Q1: IC26.2 (~Q1), J3.13, KB8.2, KB9.2, KB10.2, KB11.2, KB12.2
KBD_~Q2: IC26.3 (~Q2), J3.14, KB13.2, KB14.2, KB15.2, KB16.2, KB17.2, KB18.2
KBD_~Q3: IC26.4 (~Q3), J3.15, KB19.2, KB20.2, KB21.2, KB22.2, KB23.2, KB24.2
KBD_~Q4: IC26.5 (~Q4), J3.16, KB25.2, KB26.2, KB27.2, KB28.2, KB29.2, KB30.2
KBD_~Q5: IC26.6 (~Q5), J3.17, KB31.2, KB32.2, KB33.2, KB34.2, KB35.2, KB36.2
KBD_~Q6: IC26.7 (~Q6), J3.18, KB37.2, KB38.2, KB39.2, KB40.2, KB41.2, KB42.2
KBD_~Q7: IC26.9 (~Q7), J3.19, KB43.2, KB45.2, KB46.2, KB47.2, KB48.2
KBD_~Q8: IC26.10 (~Q8), J3.20, KB49.2, KB51.2, KB52.2, KB53.2, KB54.2
KBD_~Q9: IC26.11 (~Q9), J3.21, KB55.2, KB57.2, KB58.2, KB59.2, KB60.2
LS_SND: J3.22
