dragonplus-electronics/Atom-Iss5-V002/reset.kicad_sch

## KiCad design reset.kicad_sch (2025-06-12)

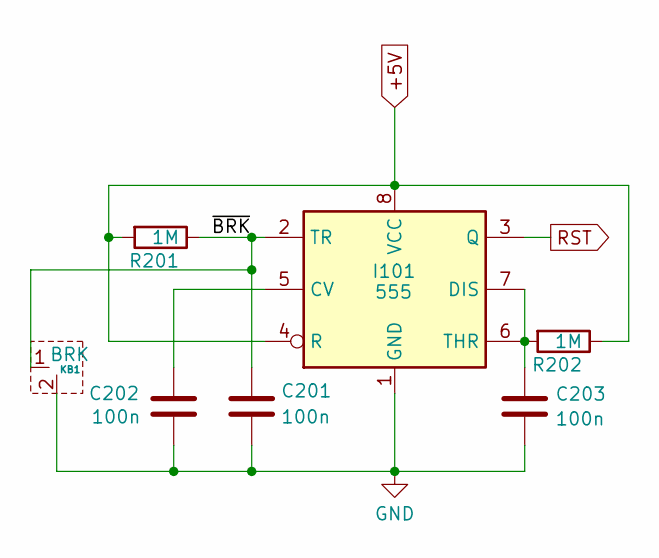
[picture p6: schematic reset.kicad_sch]

Parts:
C201, C202, C203: 100n; C_Disc_D3.0mm_W1.6mm_P2.50mm
I101: 555; DIP-8_W7.62mm
KB1: BRK; AtomKeyswitch
R201, R202: 1M; R_Axial_DIN0204_L3.6mm_D1.6mm_P5.08mm_Horizontal

Connections:
+5V: I101.4 (R), I101.8 (VCC), R201.2, R202.1
GND: C201.2, C202.2, C203.2, I101.1 (GND), KB1.2
unnamed: C202.1, I101.5 (CV)
unnamed: C203.1, I101.6 (THR), I101.7 (DIS), R202.2
RST: I101.3 (Q)
~BRK: C201.1, I101.2 (TR), KB1.1, R201.1
